devinhorowitz/Game-Boy-Enhance-desalvage/AGBM-02 (AA Batteries)/AGBM-02_BOM.xlsx

Item # | Designator | Qty | Manufacturer | Mfg Part # | Description / Value | Package/Footprint | Type | Your Instructions / Notes
1 | C1,C21,C42,C58 | 4 | Murata | GRT21BR61C226ME13K | CAP CER 22UF 16V X5R 0805 | 0805 | SMD | Can be generic
2 | C2,C12,C23,C37,C57,C59,C60,C68 | 8 | Murata | GRT188R61E106ME13D | CAP CER 10UF 25V X5R 0603 | 0603 | SMD | Can be generic
3 | C3 | 1 | Kemet | C0603C270J5GACTU | CAP CER 27PF 50V C0G/NP0 0603 | 0603 | SMD | Can be generic
4 | C4 | 1 | Kemet | C0603C330J5GACTU | CAP CER 33PF 50V C0G/NP0 0603 | 0603 | SMD | Can be generic
5 | C5-C8, C10, C13-C17, C34, C39, C43, C52, C53,C72 | 16 | Kemet | C0603C104K5RACTU | CAP CER 0.1UF 50V X7R 0603 | 0603 | SMD | Can be generic
6 | C9,C11,C22,C25,C29,C30,C36,C38,C44-C51, C54-C56,C69 | 20 | Kemet | C0603C105K4RACTU | CAP CER 1UF 16V X7R 0603 | 0603 | SMD | Can be generic
7 | C18-C20,Z57,Z58 | 3 | Kemet | C0603C101J5GACTU | CAP CER 100PF 50V C0G/NP0 0603 | 0603 | SMD | Can be generic
8 | C24,C32 | 2 | Kemet | C0603C102K5RACTU | CAP CER 1000PF 50V X7R 0603 | 0603 | SMD | Can be generic
9 | C26,C31 | 2 | Kemet | C0603C681J5GACTU | CAP CER 680PF 50V C0G/NP0 0603 | 0603 | SMD | Can be generic
10 | C27,C33 | 2 | Kemet | C0603C331J5GACTU | CAP CER 330PF 50V C0G/NP0 0603 | 0603 | SMD | Can be generic
11 | C28,C35,C61,C80 | 4 | Kemet | C0603C332K5RACTU | CAP CER 3300PF 50V X7R 0603 | 0603 | SMD | Can be generic
12 | C62-C64, C73-C79 | 10 | Kemet | C0603C103K5RACTU | CAP CER 10000PF 50V X7R 0603 | 0603 | SMD | Can be generic
13 | Z70,Z71 | 2 | Kemet | C0603C470J5GACTU | CAP CER 47PF 50V C0G/NP0 0603 | 0603 | SMD | Can be generic
14 | CP1-CP3 | 3 | Kyocera AVX | TPSB107M010R0400 | CAP TANT 100UF 20% 10V 1411 | 1210 | SMD
15 | D1,D2 | 2 | Rohm | 1SS355VMTE-17 | DIODE GEN PURP 80V 100MA UMD2 | SOD-323 | SMD
16 | DL1 (GREEN) | 1 | Wurth Elektronik | 150060VS75000 | LED GREEN CLEAR 0603 SMD | 0603 | SMD | Can be generic
17 | DL2 (RED) | 1 | Wurth Elektronik | 150060RS75000 | LED RED CLEAR 0603 SMD | 0603 | SMD | Can be generic
18 | EM1,EM2 | 2 | TDK | ACM2520-801-3P-T002 | CMC 150MA 3LN 800 OHM SMD | 6 PC Pad | SMD
19 | EM3,EM7 | 2 | Bourns Inc. | MH1608-601Y | FERRITE BEAD 600 OHM 0603 4LN | 0603 | SMD
20 | F1 | 1 | Kyocera AVX | F0805B2R00FSTR | FUSE BOARD MOUNT 2A 63VDC 0805 | 0805 | SMD
21 | L1,L2 | 2 | Samsung | CIGT201610EHR47MNE | FIXED IND 470NH 4.8A 22 MOHM SMD | 0806 | SMD
22 | P2 | 1 | Amphenol CS | 62684-402100ALF | CONN FPC TOP 40POS 0.5MM R/A | 40-pin, 0.5mm | SMD | Must be gold plated
23 | P3 | 1 | Same Sky | SJ-3524-SMT-TR | CONN JACK STEREO 3.5MM SMD R/A |  | SMD
24 | PTC1 | 1 | Littelfuse | 0805L075SLYR | PTC RESET FUSE 6V 750MA 0805 | 0805 | SMD
25 | Q1 | 1 | onsemi | MMBT3904LT1G | TRANS NPN 40V 0.2A SOT23-3 | SOT-23 | SMD | Can be generic
26 | Q2, Q5, Q7, Q9, Q10 | 5 | onsemi | NDC7002N | MOSFET 2N-CH 50V 0.51A SSOT6 | SOT-23-6 | SMD
27 | Q3 | 1 | onsemi | MMBT3906LT1G | TRANS PNP 40V 0.2A SOT23-3 | SOT-23 | SMD | Can be generic
28 | Q6,Q8 | 2 | onsemi | 2N7002 | MOSFET SOT23 N 60V 5OHM 150C | SOT-23 | SMD | Can be generic
29 | R1 | 1 | YAGEO | RC0603FR-071M5L | RES 1.5M OHM 1% 1/10W 0603 | 0603 | SMD | Can be generic
30 | R2, R15, R16, R18 | 4 | YAGEO | RC0603FR-0710KL | RES 10K OHM 1% 1/10W 0603 | 0603 | SMD | Can be generic
31 | R3, R34, R53, R58 | 4 | YAGEO | RC0603FR-075K1L | RES 5.1K OHM 1% 1/10W 0603 | 0603 | SMD | Can be generic
32 | R4,R26 | 2 | YAGEO | RC0603FR-1033KL | RES 33K OHM 1% 1/10W 0603 | 0603 | SMD | Can be generic
33 | R5-R9, R12-R14, R17, R24, R30, R31, R35, R37, R45, R46, R49, R50, R63, R65-R68, R70, R71 | 25 | YAGEO | RC0603FR-07100KL | RES 100K OHM 1% 1/10W 0603 | 0603 | SMD | Can be generic
34 | R10, R47, R52, R56, R57 | 5 | YAGEO | RC0603FR-0720KL | RES 20K OHM 1% 1/10W 0603 | 0603 | SMD | Can be generic
35 | R11, R19, R20 | 3 | YAGEO | RC0603FR-071KL | RES 1K OHM 1% 1/10W 0603 | 0603 | SMD | Can be generic
36 | R25 | 1 | YAGEO | RC0603FR-103K3L | RES 3.3K OHM 1% 1/10W 0603 | 0603 | SMD | Can be generic
37 | R29,R48,R54 | 3 | YAGEO | RC0603FR-1018KL | RES 18K OHM 1% 1/10W 0603 | 0603 | SMD | Can be generic
38 | R36 | 1 | YAGEO | RC0603FR-07270RL | RES 270 OHM 1% 1/10W 0603 | 0603 | SMD | Can be generic
39 | R38,R39 | 2 | YAGEO | RC0603FR-1347RL | RES 47 OHM 1% 1/10W 0603 | 0603 | SMD | Can be generic
40 | R40, R43, R44 | 3 | YAGEO | RC0603FR-1315RL | RES 15 OHM 1% 1/10W 0603 | 0603 | SMD | Can be generic
41 | R41 | 1 | YAGEO | RC0603FR-072K2L | RES 2.2K OHM 1% 1/10W 0603 | 0603 | SMD | Can be generic
42 | R42, R51 | 2 | YAGEO | RC0603FR-077K5L | RES 7.5K OHM 1% 1/10W 0603 | 0603 | SMD | Can be generic
43 | R59 | 1 | YAGEO | RC0603FR-07820KL | RES 820K OHM 1% 1/10W 0603 | 0603 | SMD | Can be generic
44 | R60, R73 | 2 | YAGEO | RC0603FR-0791KL | RES 91K OHM 1% 1/10W 0603 | 0603 | SMD | Can be generic
45 | R64 | 1 | YAGEO | RC0603FR-07200KL | RES 200K OHM 1% 1/10W 0603 | 0603 | SMD | Can be generic
46 | R72 | 1 | YAGEO | RC0603FR-07510KL | RES 510K OHM 1% 1/10W 0603 | 0603 | SMD | Can be generic
47 | RA1 | 1 | Panasonic | EXB-V8V331JV | RES ARRAY 4 RES 330 OHM 1206 | 1206 | SMD | Can be generic
48 | SW1 | 1 | Nidec Components | CSS-1310TB | SWITCH SLIDE SP3T 100MA 12V |  | SMD
49 | U3, U10, U17 | 3 | Texas Instruments | TPS3840DL20DBVR | IC SUPERVISOR 1 CHANNEL SOT23-5 | SOT-23-5 | SMD
50 | U4, U8 | 2 | onsemi | NCV8164ASN250T1G | IC REG LINEAR 2.5V 300MA 5-TSOP | SOT-23-5 | SMD
51 | U5, U13 | 2 | Texas Instruments | TPS63802DLAR | IC REG BUCK BOOST ADJ 2A 10VSON | VSON-10 | SMD
52 | U6 | 1 | Texas Instruments | LM4853MM/NOPB | IC AUDIO AMP AB 10-VSSOP | VSSOP-10 | SMD
53 | U7 | 1 | Texas Instruments | TLV9364QPWRQ1 | AUTOMOTIVE, QUAD, 40-V 10.6-MHZ | TSSOP-14 | SMD
54 | U9 | 1 | Texas Instruments | SN74LVC2G34DBVR | IC BUFF 1.65V SOT-23-6 | SOT-23-6 | SMD
55 | U11, U12, U18 | 3 | Texas Instruments | TPS22917DBVT | IC PWR SWITCH P-CHAN 1:1 SOT23-6 | SOT-23-6 | SMD
56 | U14 | 1 | Microchip | MIC1557YM5-TR | IC OSC PROG TIMER 5MHZ SC-74A | SOT-23-5 | SMD
57 | U15 | 1 | Texas Instruments | SN74LVC1G332DBVR | IC OR 1-CIR 3-IN SOT-23-6 | SOT-23-6 | SMD
58 | VR1 | 1 | Bourns Inc. | 3313J-2-503E | TRIMMER 50KOHM 0.125W J LEAD TOP |  | SMD
59 | VR2 | 1 | Alps Alpine | RK10J12R0A0B | THUMBWHEEL POT 10KOHM 0.03W TOP |  | SMD
60 | X1 | 1 | Abracon LLC | ABLS-4.194304MHZ-B4-T | CRYSTAL 4.194304MHZ 18PF SMD | HC-49 | SMD
