devinhorowitz/Game-Boy-Enhance-desalvage/pcbway-assembly/generated/agbm-02-cxc-handbuy.md

# Hand-buy list — agbm-02-cxc

**Generated by `scripts/bom_split.py`. Do not edit.** Every line is here because
the board says so: `exclude_from_bom` and not DNP. A part moves onto or off this
list by changing the design — see [DESIGN-DECISIONS.md](../clockxcontrol-integration/DESIGN-DECISIONS.md).

Quantities are for **1 board(s)**.

| Refs | Qty | Value | MPN | Manufacturer | Why it is not on the assembly line |
|---|---|---|---|---|---|
| `MOD1` | 1 | ClockxControl | — | — | ClockxControl mezzanine -- its plated holes are filled with solder from above onto the pads below; no pick-and-place does that |
| `P3` | 1 | SJ-3524-SMT | SJ-3524-SMT-TR | CUI Devices | CUI SJ-3524-SMT headphone jack -- 4 SMD + 4 through-hole signal pins and 2 unplated posts, so a selective-solder or hand step either way |
| `SP1` | 1 | Speaker | — | — | speaker, 2 through-hole pads and a wired mechanical part |
| `U1` | 1 | AGB-CPU | — | — | AGB-CPU, 128-pin QFP recovered from a donor board. The schematic's own Source field reads 'Salvage'. Not orderable at any price, so it cannot be on an assembly BOM; hand-fit after the reflow. |
| `VR2` | 1 | RK10J12R0A0B | RK10J12R0A0B | Alps Alpine | Alps RK10J12R0A0B volume pot -- 7 SMD pads plus 2 through-hole anchors |

## What this list is not

It does not include the shell, the screen kit, the battery contacts or the
cartridge you intend to play. Those are build choices, not design outputs, and
`OFF_BOARD` in the generator is empty on purpose rather than carrying invented
sourcing for parts nobody has picked yet.
