devinhorowitz/Game-Boy-Enhance-desalvage/(commit log)

2026-08-18 Add ClockxControl integration feasibility study
    Assesses whether the AGBM can carry a footprint for the insideGadgets GBA
    ClockxControl and drop the stock 4.194304 MHz crystal that the mod requires
    be removed.
    Findings, all traced against the AGBM-01/-02/-11 board files in this repo:
    - The clock corner is a plain Pierce oscillator (U1.113/114, R1 1.5M,
    R41 2.2k, C3 27p, C4 33p) with nothing else on CK1/CK2, so driving it
    externally is a one-node change.
    - Four of the six signals the module needs already have labelled front-side
    pads (TP80 = CK1, TP28/27/29 = L/R/SEL). Only 3.3 V and GND are missing.
    - insideGadgets' "GBA SI" is the pad silkscreened S1 on the cart connector,
    which i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
2026-08-18 Extract ClockxControl land pattern from DMGC-CPU-01 rev 2.5
    Corrects the previous study, which wrongly concluded a solder-down
    footprint was impossible. The module's I/O pads are plated through-holes:
    it floats flat on the host board and is fixed by dropping solder through
    the hole onto the pad below. MouseBiteLabs already ships exactly this on
    the Game Boy DMG Color CPU board ("Added space for adding ClockxControl
    by insideGadgets", v2.5).
    Geometry measured out of the DMGC-CPU-01_2-5 gerbers:
    - Body outline 12.000 x 18.650 mm (bottom silk, 46.000,49.500 to
    58.000,68.150).
    - Three landing pads, ø1.270 mm copper / ø1.397 mm mask, no drill.
    - Pad field is a 2.5 mm lattice: columns 2.300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
2026-08-18 ECO-6: cut the ClockxControl footprint into the GBE-plus board
    Places the insideGadgets GBA ClockxControl land pattern on this fork's
    AGBM-01_AA_1-2_GBE-plus board, wires it, and verifies it. Output board is
    clockxcontrol-integration/board/agbm-01-clockxcontrol.zip.
    Moved:
    - C7 (0603 VDD35/GND) 91.900,-41.100 rot 180 -> 82.700,-40.300 rot 0. It was
    the only part inside the one viable module window. Both its pads were fed
    by pours on the original board, so nothing was orphaned; VDD35 is tied
    back through a 0.9 mm stub to a new via at 81.025,-40.300 into the In2.Cu
    VDD35 pour (priority 26 beats the GND pour there).
    - FID2 / FID5 89.000,-48.000 -> 106.250,-57.250, out of the module out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
2026-08-18 ECO-6: all six ClockxControl landings, for a wire-free build
    Extends the footprint from three solder-through pads to six, so nothing has
    to be wired by hand.
    Added:
    - TP83 (CXC_CLK, new net 238) 99.250,-42.050; TP84 (VDD3) 100.850,-44.150;
    TP85 (GND) 100.850,-42.450. All o1.4 mm, placed as individual single-pad
    footprints so each can be dragged on its own in the PCB editor.
    - JP3, a default-open solder jumper at 45.000,-64.200 (6.9 mm from TP80),
    pads o1.05 mm at 1.3 mm pitch, net /CPU/CK1 and net CXC_CLK.
    - Routing: CXC_CLK 75.8 mm / 2 vias (mostly B.Cu through the cartridge
    keepout), VDD3 12.4 mm / 2 vias to P1 pad S1, GND 2.8 mm / 1 via, and the
    5.0 mm CK1 stub from JP3 pad 1.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
2026-08-18 Add fab-view renders, and fix two silkscreen collisions they exposed
    There is no kicad-cli in this environment, so the views are produced by a
    renderer built against the board file: outline, copper, an approximate zone
    re-pour (each zone clipped to the board, minus higher-priority zones, minus a
    0.2 mm halo around every other-net track, pad, via and hole), soldermask
    openings, silkscreen and drills. A fab preview, not a gerber export.
    - render/fab_front.png, render/fab_back.png - whole board, both sides
    - render/fab_landings.png - the landings
    - render/fab_landings_fit.png - annotated: measured landings ringed green,
    photo-derived ringed blue with a +-0.5 mm outer ring
    - render/fab_landin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
2026-08-18 CLK/V+/V- are wire pads, not landings - the module has no holes there
    Corrected against a photo of a stock ClockxControl: only the six button pads
    are plated through-holes. CLK, V+ and V- are plain top-side pads, so no
    landing under the module can ever be soldered to them. That also explains the
    DMG Color layout, which lands exactly three pads and puts these three on wire
    pads outside the outline.
    So the goal for these three is not "no wires", it is the shortest possible
    wires onto labelled pads just outside the module body:
    - TP83 CLK -> 98.600,-38.200 3.9 mm of wire
    - TP84 V+ -> 100.900,-38.200 6.0 mm
    - TP85 V- -> 103.000,-38.200 4.8 mm
    They sit in the clear pocket between the mod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
2026-08-18 Add a fit-check render with the module body drawn in place
    render/fab_fit.png draws the ClockxControl body on the AGBM front at its
    actual position: its three plated holes sitting over the MOD1 landings, its
    three other holes (unused by the GBA firmware), its hole-less CLK/V+/V- pads
    ringed at +-0.5 mm with the wires and lengths to the pads below, and a callout
    for every neighbour clearance.
    Body clearances, courtyard to courtyard, so the real body-to-body figures are
    a little larger: U2 (RAM) 0.25 mm above, R3 0.27 mm and TP114/TP115 0.35 mm
    and U10 0.47 mm to the right, P1 0.90 mm below, TP18 2.80 mm to the left.
    Claude-Session: https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
2026-08-18 ECO-6 rev B: shift the ClockxControl west, out of the R3/TP114 cluster
    Rev A put the module where pad-to-copper clearance was best, which left it
    0.25 mm from R3 and U2 and under half a millimetre from four neighbours at
    once. Moving it 1.875 mm west and 0.3 mm south takes the other side of that
    trade: worst body clearance 0.25 -> 0.55 mm, nothing inside half a
    millimetre any more, and the east side opens from 0.25 mm to 2.13 mm.
    Minimum pad-to-copper drops 0.458 -> 0.240 mm, against this ECO's own
    mask-covered escape tracks and still over the 0.2 mm netclass rule.
    The move costs two VDD2 plane-stitching vias at (84.4, -45.9) and
    (85.4, -45.9): the R landing lands on top of them, and a 0.05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
2026-08-18 Add a component-level power and quality review of the AGBM-01
    Eight parallel domain investigations over the converter path, the linear
    rails, the battery/protection path, every passive, the supporting ICs, the
    audio chain, the ClockxControl load, and thermal/EMC/layout. 102 findings,
    each then put through an adversarial pass instructed to refute by default
    and to re-fetch every datasheet rather than trust the citation: 2 refuted,
    55 of the surviving 100 revised.
    The headline: running the ClockxControl at 1.75x costs about 146 mW at the
    battery, and roughly 126 mW of that is recoverable - but only about 40 mW
    without touching the board. Five drop-in part swaps get you there; the
    AGBM-02 conv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
2026-08-18 ECO-7: mark the crystal network DNP, and stop the U2 pin-37 "fix"
    Two results from checking the component review's highest-confidence
    findings against the actual board geometry.
    IMPLEMENTED. X1, C3 and C4 now carry (attr smd dnp). Before this the
    crystal and both load caps shipped as ordinary fitted parts, so an
    assembly house would solder a crystal onto the node the ClockxControl
    drives. The diff against ECO-6 rev B is exactly three lines and touches no
    copper. Stock AGBM-01 already marks 49 footprints DNP; this makes 52.
    While confirming it, ECO-6's write-up turned out to be wrong about C4. It
    said C4 dangles once the crystal is gone. The netlist says otherwise: X1
    pad 2, C4 pad 1 and R4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
2026-08-18 Start the PCBWay assembly package: BOM resolution and sourcing audit
    The repo has no MPN BOM - the schematic carries Digi-Key short-links on 194
    of 235 symbols, 68 unique. curl gets HTTP 403 from Digi-Key's bot
    protection (not the egress proxy, which reports no relay failures);
    WebFetch resolves them.
    21 lines resolved so far covering 57 reference designators, prioritising
    the actives, the disputed parts, and everything the component review
    flagged. The remaining ~41 links are generic 0603 R/C values with no
    sourcing risk.
    Five lines have real availability problems, and two of them are bulk
    decoupling with ten placements between them: the 10 uF 0603 is out of stock
    until late December, the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
2026-08-18 Correct the power review: the overclock's energy cannot be won back
    The synthesis agents that died on 529s in the first run completed on the
    resume, and they substantially reverse the headline I published.
    WRONG BEFORE: "roughly 126 mW of the 146 mW recoverable, about 86%."
    RIGHT NOW: the module plus overclock costs about 159 mW at the battery, at
    maximum effort you recover about 69 mW (43%), and the de-duplicated drop-in
    ledger is about 20 mW off a 170 mW idle - 12%. In runtime, the overclock
    costs 79 minutes and drop-in parts buy back 14 of them.
    The earlier number summed tiers naively. The budget shows that is wrong:
    with U8 replaced by a switcher the VOUT3 trim collapses from 6.1 to 2.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
2026-08-18 ECO-8: implement the drop-in component swaps from the power review
    Thirteen Value/Description edits on the ClockxControl board. No copper, no
    land pattern, no placement -- a 26-line diff against the ECO-7 build, geometry
    byte-identical.
    U7 TLV9364 -> TLV9064IPWR correctness
    R23 1.78M -> 1.69M VOUT3 3.336 -> 3.228 V
    DL1 150060VS75000 -> 150060GS75000 InGaN green
    R25 3.3k -> 22k
    PTC1 0467001.NR -> 0805L110SLYR stale value + derating fix
    F1 0467001.NR -> F0805B2R00FSTR stale value only
    R15 10k -> 100k brownout-latch bias
    R16 10k -> 100k
    R11 1k -> 10k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
2026-08-19 Make the board reproducible and gate every document against it
    Ports the validation architecture from the solar-glow (solar-business-card)
    repo: numbered drift-guard checks, the exclusion-ledger discipline, and a CI
    pipeline. Adapted to a repo with no schematic in-tree, whose board ships inside
    a zip.
    Two claims are now enforceable:
    scripts/build_board.py the shipped board is a FUNCTION of committed inputs
    scripts/check_consistency.py the documents cannot quietly stop describing it
    Before this, the generator lived in a scratch directory and was never committed
    -- ECO-8 section 8.6 said so -- so the deliverable could not be re-derived by
    anyone, and every number in ECO-6/7/8 was a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
2026-08-19 ECO-9 + bom_split: the board now says what a machine can actually place
    Ports the second half of the solar-glow tooling -- the BOM splitter and its
    gate -- and the board change that makes its rule true here.
    THE DEFECT
    A BOM and a position file generated from the ECO-8 board asked a pick-and-place
    to buy and place 179 parts, including:
    U1 AGB-CPU, 128-pin QFP salvaged from a donor board; nobody sells it
    U2 AGB-SRAM, 96-pin TSOP same donor
    P1 cartridge slot 36 through-hole pins
    P3 CUI SJ-3524-SMT jack 4 SMD + 4 through-hole signal pins
    P4 link port 8 through-hole pins
    SP1 speaker 2 through-hole pads
    VR2 Alps volume pot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
    [agbm-01-cxc-handbuy.csv, agbm-01-cxc-not-populated.csv, agbm-01-cxc-pcbway-assembly.csv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]
2026-08-19 Resolve every MPN against the live Digi-Key and Mouser APIs
    174 of 180 buyable reference designators now resolve to a manufacturer part
    number. The other six have none BY DECISION -- U1/U2 are salvage, P1/P4/SP1/MOD1
    are aftermarket -- and each says so in its own entry rather than reading as a
    gap. Zero unresolved, down from 105 parts across 33 lines.
    HOW
    The answer was already in the repository: the upstream schematic carries a
    per-symbol Digi-Key short-link on 233 symbols, and for a generic value like `1u`
    or `100k` that link is the ONLY record of which part MouseBiteLabs picked. curl
    gets 403 from www.digikey.com (their bot protection), so the 34 links covering
    the unresolved set were r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
    [agbm-01-cxc-handbuy.csv, agbm-01-cxc-not-populated.csv, agbm-01-cxc-pcbway-assembly.csv]
2026-08-19 Swap the 10 uF line to Murata's GRT part, and stop the ledger claiming stock
    C2/C12/C23/C37/C59/C60/C68: GRM188R61E106KA73J -> GRT188R61E106ME13D.
    The incumbent is at ZERO stock at both distributors with a 17-week lead. The
    replacement has 192,299 at Digi-Key.
    Verified parameter by parameter against the incumbent on the Digi-Key API:
    capacitance 10 uF, rated voltage 25 V, dielectric X5R, package 0603 (1608), max
    thickness 1.00 mm and operating range -55 to +85 C are ALL IDENTICAL. Two
    differences, both neutral or better here: tolerance loosens +/-10% to +/-20%,
    immaterial on bulk decoupling and dwarfed by DC-bias derating anyway; and the
    GRT is Murata's soft-termination series and is AEC-Q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
    [agbm-01-cxc-pcbway-assembly.csv]
2026-08-19 Swap the 22 uF line to a 25 V part -- the earlier "none exists" was my error
    C1/C21/C42: GRM21BR61E226ME44L -> GRT21BR61E226ME13L.
    CORRECTION. The previous commit said "NO LIKE-FOR-LIKE EXISTS -- every 22 uF
    25 V X5R 0805 from a tier-1 maker is at zero" and recommended dropping to 16 V.
    That was wrong. It came from a keyword search filtered on stock >= 5,000, which
    silently excluded every real 25 V candidate: all of them sit in the hundreds to
    low thousands. A threshold chosen to shorten a search result had turned into a
    claim about the market.
    A deeper sweep -- 1,297 results across 15 query shapes with no stock floor, plus
    an independent Mouser keyword sweep -- found three 25 V parts in s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
    [agbm-01-cxc-pcbway-assembly.csv]
2026-08-19 ECO-10: the precision pass -- and the FB dividers were the loudest thing here
    Six Value changes and 23 MPN upgrades. No copper. A premium variant of the
    AGBM-01: nothing here is a bug fix, except that section 10.1 turned out to be a
    real error term nobody had accounted for.
    THE FINDING
    The LTC3527 specifies its own feedback input current as 1 nA typ / 50 nA MAX.
    With the dividers as built, that worst case moves the rails more than the
    resistors do:
    VOUT3 1.69M / 1.00M 1.20 uA +/-85 mV (+/-2.62%)
    VOUT5 1.78M / 560k 2.14 uA +/-89 mV (+/-1.77%)
    ECO-8 trimmed VOUT3 by 108 mV to save 6.1 mW. The worst-case uncertainty on
    that trim was 85 mV -- the trim was very nearly inside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
    [agbm-01-cxc-pcbway-assembly.csv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]
2026-08-19 Sync with upstream MouseBiteLabs, and verify the ECO chain still sits on it
    Merged MouseBiteLabs/Game-Boy-Enhance @ 48e2dc3. We were 2 commits behind and
    the entire change is one file: a KiCad .gitignore contributed by bytendomods
    and merged upstream today.
    THE MORE USEFUL RESULT is what the sync confirmed rather than what it brought.
    Every design file in this fork is now verified BYTE-IDENTICAL to upstream's
    current state -- AGBM-01's Design Files and gerbers, AGBM-02, AGBM-11, all of
    it. That is the property the whole ECO chain rests on: build_board.py
    regenerates the board from agbm-01-ram-desalvage.zip, which is ECO-5's fork of
    upstream's AGBM-01_Design Files. If that ever stopped being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
2026-08-19 ECO-11: fix the gate drive the latch actually needs; refuse the D1 finding
    Two correctness items the review flagged. One is real and is fixed. The other
    does not survive checking, and the correction matters more than the fix would.
    Q9 / Q10 -> FDC6301N. TWO VALUES, NO COPPER.
    NDC7002N VGS(th) is 1.0 / 1.9 / 2.5 V MAX, with no RDS(on) spec below VGS =
    4.5 V at all. The drive those two parts get:
    Q10A ~14 uA through the TPS3840's 100 kOhm INTERNAL MR pull-up, at
    VGS ~= 2.0 V (SW - Vce(sat)) at the 2.07 V trip
    Q10B VGS = 0.990 x SW -- 2.05 V at the trip
    Q9B ~165 uA for DL2, gate = /D1A ~= 3.0 V
    A worst-case part is at or below its own threshold in all three, and the
    thresh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
    [agbm-01-cxc-pcbway-assembly.csv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]
2026-08-19 ECO-12: the wiki audit -- we were ordering values Nick never used
    Read all 21 pages of the MouseBiteLabs project wiki against every ECO in this
    fork. The question was not "is our reasoning sound", it was "did we quietly undo
    something Nick fought for". Two answers changed the board.
    R3/R4/R64 -- the schematic-vs-PCB conflict ECO-8 and ECO-10 both deferred is a
    stale PCB annotation, and this fork had the regression live. ECO-9 derives the
    PCBWay BOM from the board's Value fields, so we were ordering 1k/10k/100k. Four
    independent confirmations of 5.1k/33k/200k: the AGBM-02 PCB carries them (same
    AA design, one revision later, identical supervisor circuit), both AA README
    BOMs buy them, the wi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
    [agbm-01-cxc-pcbway-assembly.csv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]
2026-08-19 Correct the U2 land recommendation: it cannot be a footprint swap
    Tried to do what the last commit recommended -- replace ECO-5's U2 land with
    AGBM-02's AGB-SRAM_2 geometry -- and it does not work. Testing it is what
    proved it wrong, so the recommendation is corrected rather than quietly
    dropped.
    Nick's land and Nick's routing are one design. On AGBM-01 the channel
    immediately west of U2's left pad column is where the ENTIRE RAM address bus
    escapes: 37 F.Cu segments on MA_1..MA_15, ~WE_RAM, ~LB, ~UB and GND, fanning
    out from x=81.31 toward the CPU. Dropping his pad field at x=-8.45 onto that
    copper, tested segment-against-pad-rectangle, shorts 15 of the 24 new pads
    across 12 nets -- VDD2 to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
2026-08-19 ECO-13: rebase onto MouseBiteLabs' AGBM-02, and cull ECO-5
    The base board is now his AGBM-02, unmodified. It was our ECO-5 AGBM-01
    desalvage -- footprint work he never saw and never used.
    WHY. Adopting his RAM land means adopting his board. Dropping AGB-SRAM_2 onto
    the AGBM-01 layout was tried and does not work: the channel west of U2's left
    pad column is where the entire RAM address bus escapes, 37 F.Cu segments on
    MA_1..MA_15, ~WE_RAM, ~LB, ~UB and GND, and his pad field at x=-8.45 shorts 15
    of the 24 new pads across 12 nets. He could put the column there on AGBM-02
    because he re-routed the fanout. His land and his routing are one design.
    And "both" is cheap: of 230 shared refdes, 217 si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
    [agbm-01-cxc-handbuy.csv, agbm-01-cxc-not-populated.csv, agbm-01-cxc-pcbway-assembly.csv, agbm-02-cxc-handbuy.csv, agbm-02-cxc-not-populated.csv, agbm-02-cxc-pcbway-assembly.csv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]
2026-08-20 ECO-14: audit the ClockxControl work on the new base -- and one open question
    Answering "was the overclocker work done on Nick's latest PCB?" -- yes, and
    confirmed four ways: our branch contains upstream HEAD 48e2dc3 with all three
    design archives byte-identical; AGBM-02's kicad_pcb is dated 2026-08-16 against
    AGBM-01's 06-04 and AGBM-11's 06-28; AGBM-12 has no design files at all; and his
    own on-board dot-code revision stamp decodes to July '26 against June for the
    other two. The dot code validates itself -- AGBM-01 reads first-third-of-June
    against a file saved 06-04, AGBM-11 last-third-of-June against 06-28, both exact.
    Note his silkscreen stamp is ~6 weeks behind his file, so a fabbed bo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
2026-08-20 ECO-14 section 14.1: RESOLVED -- our supply tap is the vendor's own
    Checked insideGadgets' ClockxControl documentation for the supply voltage and
    output level, which section 14.1 named as the first thing to verify.
    THE SUPPLY TAP IS SETTLED, AND WE ALREADY MATCH IT. Their GBA install list reads
    "Device V+ to GBA SI" -- and "SI" is a typo for the pad silkscreened S1. That is
    now confirmed from their own install photo rather than inferred: enlarging
    IMG_6317.jpg shows the red V+ wire soldered onto the rightmost pad of the
    C2 S2 C1 S1 group at the end of the cartridge connector's solder row, silkscreen
    and joint both unambiguous. And S1 is the 3.3 V rail on both boards:
    AGBM-02 base : P1.C2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
2026-08-20 ECO-14: fix the DRC violation and move the fiducials off the pours
    THE VIA. Moved (47.45,-59.60) -> (47.50,-59.50). Worst foreign clearance goes
    0.1632 -> 0.2321 mm against the project's single Default netclass rule of 0.200.
    The limiting object changes from C13 pad 1 (VDD5, B.Cu) to a /CPU/CK1 F.Cu track;
    C13 itself is unmoved by every ECO, so the violation was entirely our via. Both
    adjoining segments moved with it and were re-measured: F.Cu leg 0.3605 mm, B.Cu
    leg 0.2707 mm.
    The 0.032 mm margin is thin and that is not for want of trying. A 0.05 mm grid
    search over a 3x4 mm corridor and a second search around JP4 put every
    alternative worse -- next best +0.2176, then +0.1750, then +0.0341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
2026-08-20 ECO-14 follow-up: close three recorded-not-fixed items, add checks [2b] and [14]
    Three of the five items ECO-14 §14.5 recorded as open were fixable without
    KiCad. All three are now closed, and each closes behind a gate rather than a
    promise.
    Derive the library footprint from the board, not beside it
    ClockxControl_GBA_GBC.kicad_mod was a hand-kept second copy: centre text at
    1.2 against the board's 1.05, four extra silk strings, reference "MOD" not
    "MOD1". The drift was the symptom; the fault was that check [2] compared the
    zip to the tree and never the .kicad_mod to the board, so any future
    divergence would have been equally invisible. build_board.py grows
    library_footprint(),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
2026-08-20 Commit the missing renderer; fix two defects it found in the gates
    ECO-14 §14.5 recorded the renders as "pre-rebase, regenerating needs KiCad".
    That was wrong, and being wrong about it was the useful part. ECO-6 §6.6 said
    the views came from "a renderer built against the board file directly" -- and
    that renderer was never committed. The PNGs were orphaned outputs of a lost
    tool, the same defect as the hand-kept .kicad_mod in a different medium, which
    is why they went on describing AGBM-01 through the entire ECO-13 rebase with
    identical git blob SHAs.
    scripts/render_board.py is the missing generator
    Seven views derived from the board through the same kisexp/geom readers every
    gate uses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
2026-08-20 ECO-15: read MouseBiteLabs' own part links; fix three lines we had made unbuyable
    Every symbol in the upstream schematic carries a (property "Source" ...)
    Digi-Key link. That link is the only record of which part Nick actually chose
    for a generic value like "22u" -- the Value field is a symbol name, not an
    orderable code. scripts/link_mpn.json resolves those links.
    It was built from AGBM-01 and survived the ECO-13 rebase untouched. AGBM-02's
    schematic has 57 links; the map had 34, of which 7 were AGBM-01 leftovers. So
    30 of Nick's part choices had never been read -- including SW1, P3, D1/D2, the
    whole 22 uF line and the tantalum bulk caps. Same defect as the pre-rebase
    renders and the hand-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
    [agbm-02-cxc-pcbway-assembly.csv]
2026-08-20 ECO-16: borrow Solar-Glow's render pipeline, raytrace the board as PCBWay ships it
    Board unchanged -- no copper, no attributes. Four raytraced views, a new
    generator, and two gate changes.
    What was borrowed
    solar-business-card's scripts/render.py drives kicad-cli. Its targets were no
    use (it renders BARE boards and strips every body) but the three disciplines
    around the four-line kicad-cli call were, each of which exists because that
    project got burned:
    1. every target renders from a throwaway copy, never the committed board
    2. zones are refilled on the copy first -- kicad-cli pcb render has no
    --refill-zones and draws the fill as STORED
    3. model resolution is reported o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
2026-08-20 ECO-17: paste follows the placement list; U2 gets the RAM the BOM actually buys
    Raised from reading ECO-16's renders. Two real fab defects, both caught before
    an order rather than after.
    A stencil cannot read `dnp`
    ECO-9 encoded who places what in the board's attributes. The paste layer
    never got the memo. A stencil is cut from F.Paste/B.Paste and knows nothing
    about dnp or exclude_from_pos_files, so paste goes down on every aperture and
    reflows whether a part lands on it or not. That was 254 apertures across
    thirteen parts nobody places:
    U1 128 the salvaged CPU, hand-fitted after reflow -- 128 bumps on a
    0.5 mm-pitch land to wick off before it can seat
    SW6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
    [agbm-02-cxc-cpl.csv]
2026-08-20 ECO-18: the CPL rotation convention, verified part by part
    Board unchanged -- no copper, no pads, no placements. Two pin-1 views, check
    [18], one negative case. Closes the open item pcbway-assembly/README.md has
    carried since ECO-9.
    Step one: the rotations are kicad-cli's own
    Our CPL is generated by bom_split.py, not by KiCad, so "it emits KiCad's
    rotation" needed proving. Exported the shipped board with kicad-cli pcb
    export pos and compared row by row:
    kicad-cli rows: 181 our CPL rows: 180
    x differs: 180 y differs: 180 rot differs: 0 (of 180)
    Zero rotation differences on all 180 parts. x/y differ only in datum -- KiCad
    measures from the page origin, ECO-17's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
2026-08-20 ECO-19: restore the stock C7 land as a DNP alternate; run KiCad's DRC
    ECO-6 moved C7 out of the module window because it was the one part standing
    in it. That quietly cost something: third-party mods that solder to C7 where it
    has always been lose their landmark, which makes this fork a SIDE-GRADE rather
    than an upgrade. C7 sits at (91.9,-41.1) on AGBM-01 AND AGBM-02 -- byte
    identical across two revisions of MouseBiteLabs' own design -- and a position
    that stable is exactly what an outside mod keys off.
    So the land goes back as C7A, unpopulated. Nearly free, and each reason checked
    rather than assumed:
    * ECO-6 recorded that C7 had NO TRACKS -- both pads were fed by pours. The
    VDD35 an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
    [agbm-02-cxc-not-populated.csv]
2026-08-20 ECO-20: close both open DRC defects -- U1 pin 39's ground, and six misplaced fiducials
    KiCad's DRC, first run in ECO-19, found two things this fork was shipping.
    Both are fixed here, and both turned out to be the same kind of mistake:
    geometry asserted in a comment instead of measured from the board.
    U1 pin 39 [GND] had no ground connection. ECO-6's /CPU/TP8 route passes
    0.3594 mm from the pad's copper at (73.372, -46.628) where a pour sliver
    needs 0.400 -- 0.2 mm of zone clearance to TP8 plus the zone's own 0.2 mm
    min_thickness. Forty-one microns short. KiCad keeps a fill island that
    touches a pad, so the land LOOKS connected in every render and every plot
    while being joined to nothing. Wi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
    [agbm-02-cxc-cpl.csv]
2026-08-20 Re-render everything from the ECO-20 board
    The nine 2D views come back byte-identical -- render_board.py is pure
    Python and its output is a function of the board alone, which is what
    check [15] asserts. The four raytraced views differ, as they always do:
    kicad-cli's raytracer is not byte-reproducible, so check [15] holds those
    to presence and body-resolution rather than to pixels.
    Nothing about the board changed. This is the render pass re-run on the
    committed board so the shipped package carries pictures made from it.
    check_consistency.py 0 errors, 2 pre-existing warnings
    assembled renders 175/180 bodies resolve, 99 zones refilled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
2026-08-20 Fix CI: tell "the check declined to run" apart from "the check is blind"
    The consistency workflow has been RED on every commit since ECO-16 and I
    never looked at it. Local runs were green the whole time, which is how it
    stayed hidden.
    test_checks.py counts a case as BLIND when its check does not fire. Two
    checks legitimately cannot run on the bare runner this gate is built for:
    [15] needs Pillow and [18] needs kicad-footprints, and the workflow
    installs neither -- that is the same deliberate no-container choice that
    keeps the gate at five seconds with no digest to rot. Both checks say so
    and return. The meta-test could not tell that from a matcher that
    silently reads nothing, so it exited 1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
2026-08-20 Refresh the live stock data; correct a stale claim that U14 does not matter
    Re-queried both distributors for every buy line. 41 of 69 lines moved.
    The two lines check [6] warns about are STILL zero at both, so the
    warning was current, not stale:
    U14 MIC1553YM5-TR Digi-Key 0 @ $0.11, 24-week lead, Active
    Mouser 0 @ $0.11
    U11/12/18 TPS22917DBVR Digi-Key 0 @ $0.52, 16-week lead, Active
    Mouser 0 @ $0.52
    Their alternates were checked live rather than carried forward:
    TPS22917DBVT same die, smaller reel -- Digi-Key 10,879 @ $1.14,
    Mouser 1,973 @ $1.13. A reel change at order time.
    Neith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
2026-08-20 ECO-21: the 22 uF line goes to 25 V, and no part in that body preserves everything
    C1 sits on /VFILT, C21 and C58 on VOUT5, C42 on VOUT3. A class-II ceramic
    loses capacitance to DC bias, and a 16 V part loses more of it at a given
    working voltage than a 25 V one in the same body. ECO-15 knew that and took
    the 16 V part anyway, for a good reason at the time: the 25 V part this fork
    had been buying had gone to zero, and so had the GRM it was itself swapped
    from. Two swaps in a row had chased availability onto dead lines. This buys
    the headroom back.
    The sweep that made it a decision rather than a swap: every 22 uF / 25 V /
    0805 part at both distributors, 2026-08-20, five query shapes, no stoc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
    [agbm-02-cxc-pcbway-assembly.csv]
2026-08-20 ECO-22: read the board's own DRC rules, and delete the via they condemn
    check_drc.py wrote the board into an empty temp directory and ran
    kicad-cli on it. KiCad keeps design rules in the PROJECT, not the board,
    so with no .kicad_pro beside it every run since ECO-19 fell back to
    KiCad's built-in defaults. MouseBiteLabs has shipped a .kicad_pro inside
    AGBM-02 Design Files.zip the whole time.
    It differs from the defaults in both directions. He sets silk_overlap,
    silk_over_copper, text_height, lib_footprint_issues, lib_footprint_mismatch
    and silk_edge_clearance to `ignore`, and ships 113 pre-triaged
    drc_exclusions -- 489 of the 710 violations in a KiCad 10 report are
    checks he deliberately turn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
2026-08-20 ECO-23: ship a KiCad 10 copy, and prove it is the same copper
    You are on KiCad 10; the repository is KiCad 9. Neither reads the
    other's file -- a KiCad 9.0.9 kicad-cli handed a version-20260206 board
    answers "Failed to load board" -- and the two formats are different
    encodings, not a superset and a subset: nets by name instead of number,
    no net table, (drill 1 (offset 0 0)) instead of (drill 1), capping /
    covering / plugging on every via.
    build_board.py makes this fork by splicing text into MouseBiteLabs'
    KiCad 9 board, which is the only reason check [1] can assert the shipped
    file rebuilds byte-for-byte from his committed zip. His base is KiCad 9,
    so making KiCad 10 the source of truth wou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
2026-08-20 ECO-24: stamp the renders with the board they were drawn from
    Nothing renders automatically -- the renderers are run by hand and
    pack_board.py sweeps whatever PNGs are in render/ into the deliverable.
    Check [15] was the guard: it re-renders in memory and compares pixel
    digests against the committed files.
    That guard never ran on CI. Re-rendering needs Pillow and this
    workflow installs nothing on purpose ("NO CONTAINER, NO PINNED IMAGE,
    NO pip INSTALL"), so [15] reported "did not run" on every push,
    test_checks counted it as a declared skip, and a board change committed
    without re-rendering would have passed a fully green pipeline. The
    pictures would have been of a board that no longer exist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
2026-08-20 Regenerate the renders; record that the raytracer is not deterministic
    Ran both renderers on the current board. The result splits cleanly and
    the split is the useful part:
    render_board.py 9 views, ALL BYTE-IDENTICAL -- not in the diff
    render_assembled.py 4 views, all four changed
    The board did not move. Neither did KiCad, the 3D library, or the
    machine. Two consecutive runs, nothing altered in between:
    agbm02_pcbway_top 40,309 of 2,342,592 px differ (1.72%), max delta 30
    agbm02_pcbway_bottom 44,630 of 2,342,592 px differ (1.91%), max delta 31
    agbm02_finished_top 43,685 of 2,342,592 px differ (1.87%), max delta 38
    agbm02_finished_bottom 45,127 of 2,342,592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
2026-08-21 ECO-25: merge the silkscreen edits ECO-22 failed to notice
    The user moved silkscreen in KiCad, uploaded the board, and did not see
    it in the renders. They were right, and the reason is a flat error in
    ECO-22.
    That ECO compared their upload against the committed board and reported
    it "functionally identical", listing every difference as a KiCad 10
    artifact. The comparison covered footprints, pads, vias and track
    coverage. It never looked at silkscreen. "No footprint, value, net or
    route was altered" was true clause by clause and false as a summary,
    because it implied a completeness the comparison did not have. Five
    deliberate edits were therefore never merged, and every render since --
    inclu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
2026-08-21 ECO-26: the third blind reader, and the CLOCKXCONTROL label it hid
    ECO-25 widened check [19] to cover silkscreen and reported this fork's
    silk identical to the user's upload. It was not. MOD1's CLOCKXCONTROL
    label had been moved from (0, 0) -- dead centre of the module body,
    printing over MouseBiteLabs' own silkscreen -- out to (-2.538, 2.7004).
    The reason is one anchor in a regex:
    r'\((?:xy|start|mid|end|center|at) ([-\d.]+) ([-\d.]+)\)'
    anchored on the closing paren after the second number. A text item is
    placed WITH A ROTATION -- `(at 0 0 180)`, three numbers -- so the
    pattern matches nothing, findall returns [], and the position becomes
    the empty tuple. Every fp_text on this board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
2026-08-21 Rebuild onto Nick's August board, and cull the ECO chain to one document
    Two things, delivered together because the cull's gates had to pass against
    the new base.
    REBUILD ONTO THE AUGUST AGBM-02
    MouseBiteLabs re-uploaded the AGBM-02 design files on 2026-08-20. His note:
    "Narrowed pads for FFC connector for solderability (and to appease PCBway)."
    The merge commit before this one brings his zip in; this one rebuilds on it.
    * P2, the 40-pin FFC display connector: 40 lands from 0.35 x 1.25 mm to
    0.30 x 1.25 mm, unmoved, on unchanged 0.5 mm pitch. Adjacent-land gap
    0.15 -> 0.20 mm. The shield land (pad 0) is untouched.
    * Against his own DRC rules that removes 39 violations from the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
2026-08-21 Add a hero render, and put it at the top of the README
    render_assembled.py grows a fifth target. Its TARGETS entries carry a camera
    override now -- a dict of {"size", "flags"} handed to kicad-cli -- so a view can
    be framed for looking at rather than for checking, without any of the other four
    losing the flat orthogonal camera that makes them comparable.
    The hero is a three-quarter perspective with the floor shadow on, 2384x1008,
    carrying the same parts as finished-top. It comes off the same re-poured
    throwaway copy as every other assembled view, so it cannot show a board this
    repository does not ship -- it is the same board, angled.
    The renders themselves did not need regenerating for Nick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
2026-08-21 Give the back side the hero treatment too
    agbm02_hero.png becomes agbm02_hero_top.png and gains agbm02_hero_bottom.png,
    so the pair matches the naming every other view pair here already uses.
    The Z rotation is MIRRORED between them -- -7 on the front, +7 on the back --
    so the two read as one board turned over rather than two boards tilted the same
    way. Everything else is identical: same camera, same parts, same re-poured
    throwaway copy the other four assembled views come off.
    The back view happens to put P2 squarely in frame, which is the connector
    MouseBiteLabs narrowed the lands on in his August revision.
    Both go at the top of the root README. Checks: [8] 16 displayed images, [15] 6
    ass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
2026-08-21 Second cull pass: five factual errors, and the ECO tags that shipped
    The renders go into DESIGN-DECISIONS.md where they carry meaning rather than
    decoration: the front hero under section 1, which is where the module window is
    decided, and the back hero under section 12, because P2 is what that section is
    about.
    ERRORS FOUND BY RE-DERIVING EVERY CHECKABLE NUMBER IN THE DOC
    * U2 was described as SALVAGE on the hand list. It is not, and that is the
    whole point of a desalvage fork: AGBM-02 carries MouseBiteLabs' own dual
    land, so U2 is an ordinary orderable Infineon CY62157EV30LL-45ZXIT the
    machine buys and places. A build needs exactly ONE chip off a donor -- the
    CPU. resolv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
    [agbm-02-cxc-pcbway-assembly.csv]
2026-08-21 Sweep the last ECO tags out of the scripts
    241 tags in rationale comments, plus the bare "ECO"/"ECOs" the earlier pass
    never matched, plus the ones in routes.json, link_mpn.json, the workflow header
    and the two BOM files. What is left is two lines in scripts/README.md saying the
    tags existed and that git log --grep still finds them.
    This is not a search-and-replace. A blanket substitution produced prose like
    "the the AGBM-01 base base board" and "the value swaps said so in its own
    section 8.6", because these were NAMES and the sentences were built around them
    being names. Every one of the 347 changed lines was read and repaired by hand.
    build_board.py's header was an index keyed by ECO numb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
2026-08-21 Put the fiducials and the part swaps on the root README
    The README said what the fork ADDS to the board and nothing about what it does
    to the power budget, which is the thing a builder actually wants to know before
    fitting a module that draws 12 mA whether or not it overclocks.
    FIDUCIALS. Six, three per side, not paired, both triangles scalene so a machine
    cannot register the panel 180 degrees out. MouseBiteLabs ships none because he
    hand-builds; the assembly split's whole premise is that a machine builds most of
    this board. Each site clears five things at once and check [13] re-measures all
    six every run.
    THE SWAPS, AND WHAT THEY BUY. Eleven value changes and two corrected
    descriptions. B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
2026-08-21 Put the power figures on the PCBWay README, and gate them
    The ordering document needed these framed differently from the root README.
    A buyer does not need the fork's net cost; they need to know which lines are
    this fork's choice rather than MouseBiteLabs', and what falling back to his part
    costs when a distributor is dry. So the table there is PER LINE, with a column
    for what reverting gives up:
    * U7 is the one to guard. It is not an efficiency swap -- MouseBiteLabs'
    TLV9364 is specified 4.5 V to 40 V and sits on the 2.5 V VAUD rail, below
    its own minimum. It is also 12.0 mW, more than half the total.
    * PTC1 is hold-current margin, not energy: his part derates to 0.55 A at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
2026-08-21 The PCBWay upload package
    pcbway-assembly/fab/agbm-02-cxc-pcbway.zip is the file you upload: gerbers for
    all 11 plot layers, Excellon drill with PTH and NPTH separate, the position
    file, the assembly BOM, the do-not-populate list, and an ORDER.txt carrying the
    stackup so it travels with the upload instead of living in someone's memory.
    IT IS NOT PLOTTED FROM THE COMMITTED BOARD, AND THAT IS THE WHOLE POINT
    The committed fill is MouseBiteLabs' own, from before this fork added copper --
    deliberately, so check [14] can keep proving we did not re-pour. 22 of this
    fork's objects sit inside a foreign-net pour that fill has never been recomputed
    around. Plotting it would ship shorted copper.
    So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
2026-08-21 The order sheet said 1.2 mm. It is 1.0 mm
    Caught by the user against MouseBiteLabs' own repo, and it is the worst kind of
    error this package could carry: nothing in a gerber states a board thickness, so
    it survives every check in this repository, every DRC, and the fab house's own
    review, and surfaces as boards that do not fit a shell.
    WHERE 1.2 CAME FROM
    The KiCad file carries `(general (thickness 1.2))` and a stackup whose layers sum
    to exactly 1.2 mm, so reading it looked like reading the board. It is not. His
    README -- for AGBM-01, AGBM-02 and AGBM-11 alike -- says:
    - Thickness: 1.0mm
    - Layers: 4
    - Surface Finish: ENIG (HASL is acceptable ONLY IF you are using tactile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
2026-08-21 Put every PCBWay form answer in the order sheet, measured
    The form asks for numbers the gerbers cannot carry, and each one is a price tier
    or a rejection: declare tighter than you need and you overpay, looser and DFM
    bounces it. So fab_facts() measures them off the board.
    Size .............. 131.32 x 72.43 mm
    Min track ......... 0.2000 mm = 7.87 mil, and the FFC lands sit on a 0.200 mm
    gap -- so 6/6 mil, because 8/8 is a hair too tight to
    declare on either count
    Min hole .......... 0.30 mm
    Copper ............ 1 oz outer and inner, off the stackup
    Via process ....... TENTING VIAS, and this one was verified rather than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
2026-08-21 Put the assembly-quote counts on the order sheet, measured
    PCBWay's assembly form asks for four numbers the package did not carry: unique
    parts, SMD, through-hole and BGA/QFP. ORDER.txt had placements, BOM lines and
    DNP, which are not the same questions.
    fab_package.assembly_counts() derives all four from the board and the BOM:
    Unique parts 67 distinct MPNs across 68 BOM lines. C0603C101J5GACTU is on
    two lines because the schematic value strings differ (100p and
    "100p or 0 ohm") -- one feeder, not two, and the sheet says so
    SMD 180, every placement
    Through-hole 0. The 29 through-hole footprints are all do-not-populate
    BGA / QFP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
2026-08-21 Derive the sensitive-parts warnings instead of asserting them
    Two classes of part need saying out loud on a turnkey order, and the order sheet
    carried one of them as a hand-typed sentence and the other not at all.
    POLARITY. CP1-CP3 are 100 uF 10 V molded tantalums whose land is mirror-symmetric
    and whose silkscreen is mirror-symmetric too, so the board says nothing about
    which end is which. A line that reads the rotation the wrong way fits all three
    backwards and nothing downstream catches it -- not DRC, not AOI, not a visual
    check -- and a reversed tantalum fails shorted.
    polarity_risk() now finds them rather than trusting a sentence: polarised comes
    from the distributor's own description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
2026-08-22 Ship a flat gerber+drill zip, because folders hid the drill files
    PCBWay's file review came back with "there is no drill file included in your
    design." Both drill files were in the archive and both are valid Excellon --
    M48, metric, FMAT,2, 9 tools / 640 hits / 10 slots on the PTH file and 1 tool /
    2 hits on the NPTH -- sitting one directory down in drill/. Their intake reads
    the archive flat, so a drill file in a folder is a drill file nobody sees.
    There are now two zips. agbm-02-cxc-pcbway.zip stays the record: gerbers and
    drill in folders, plus the assembly CSVs and ORDER.txt. agbm-02-cxc-gerbers.zip
    is what goes in the PCB file box -- 13 files, flat, fabrication data only.
    Flattening is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
2026-08-22 The tantalums are marked: fix the reader that could not see it
    Devin spotted a "+" beside CP1, CP2 and CP3 on the board. He is right, and
    everything this repository said about their polarity was wrong.
    Each of the three carries a gr_text "+" on F.SilkS, 1.83 mm from pad 1 and
    4.77 mm from pad 2. CP2's sits on the opposite side of the part because CP2 is
    rotated 180 degrees -- the marks track the placement, which is what shows they
    were put there deliberately rather than landing near by accident. Pad 1 on each
    carries the driven audio net and pad 2 a local net, so the "+" is at the anode.
    polarity_risk() missed them twice over, and both holes were mine. It read
    silkscreen only from INSIDE t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
2026-08-22 Put the copper layer map in ORDER.txt, read off the gerbers
    A fab types the L1..L4 mapping into a form, and the sheet did not carry it.
    copper_layer_map() reads each copper plot's own Gerber X2 attribute --
    %TF.FileFunction,Copper,L1,Top*% -- so the stack order is not something the
    sheet has to be told and cannot get wrong:
    L1 top ...-F_Cu.gtl
    L2 inner ...-In1_Cu.g1
    L3 inner ...-In2_Cu.g2
    L4 bottom ...-B_Cu.gbl
    The Protel extensions say the same thing independently, which is the
    cross-check: if the two ever disagree, one is a renaming accident.
    Two more facts a fab asks for and the sheet was silent on. Neither inner layer
    is a solid plane -- L2 carries 246 track segm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
